kiieran/machine-vision-sorting-arm---MSc-Dissertation/media/Arm_1.jpg

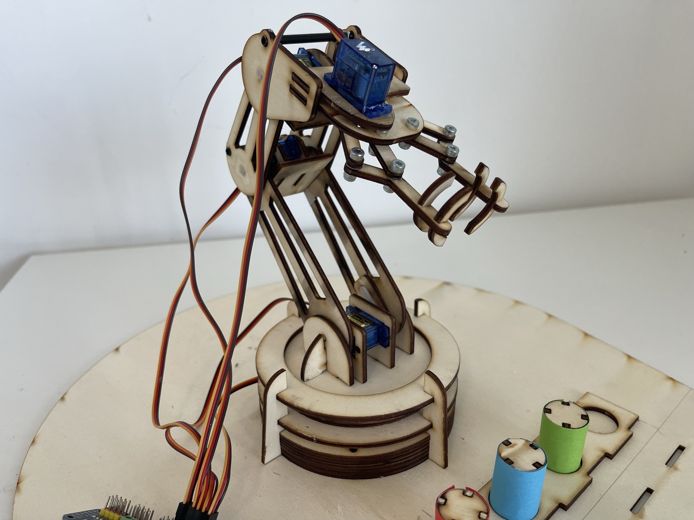
media/Arm_1.jpg
