kiieran/machine-vision-sorting-arm---MSc-Dissertation/media/Arm_2.jpg

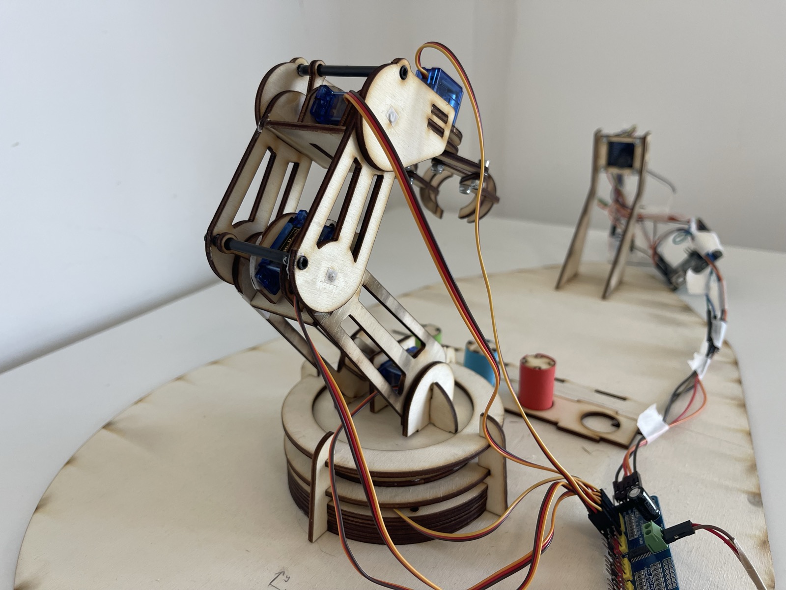
media/Arm_2.jpg
