kiieran/machine-vision-sorting-arm---MSc-Dissertation/media/arm_short.gif

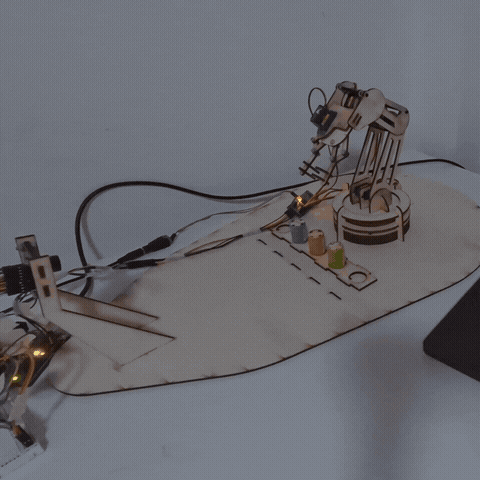
media/arm_short.gif
