kiieran/machine-vision-sorting-arm---MSc-Dissertation/media/Base_bearings_3.jpg

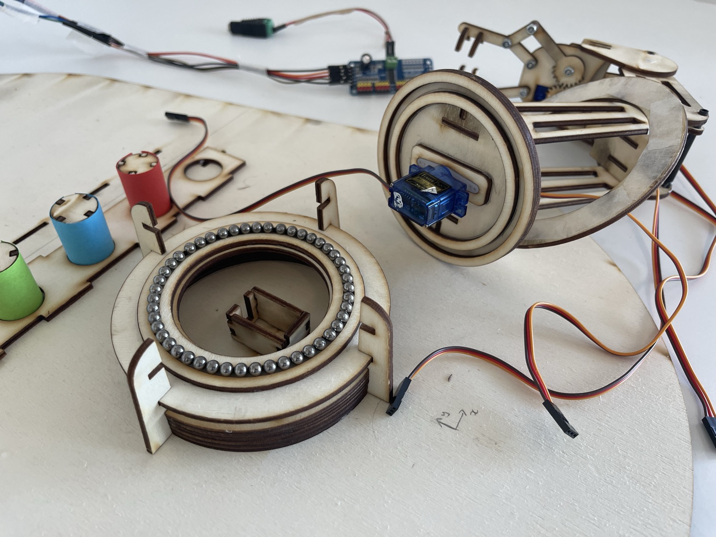
media/Base_bearings_3.jpg
