kiieran/machine-vision-sorting-arm---MSc-Dissertation/media/Base_bearings_4.jpg

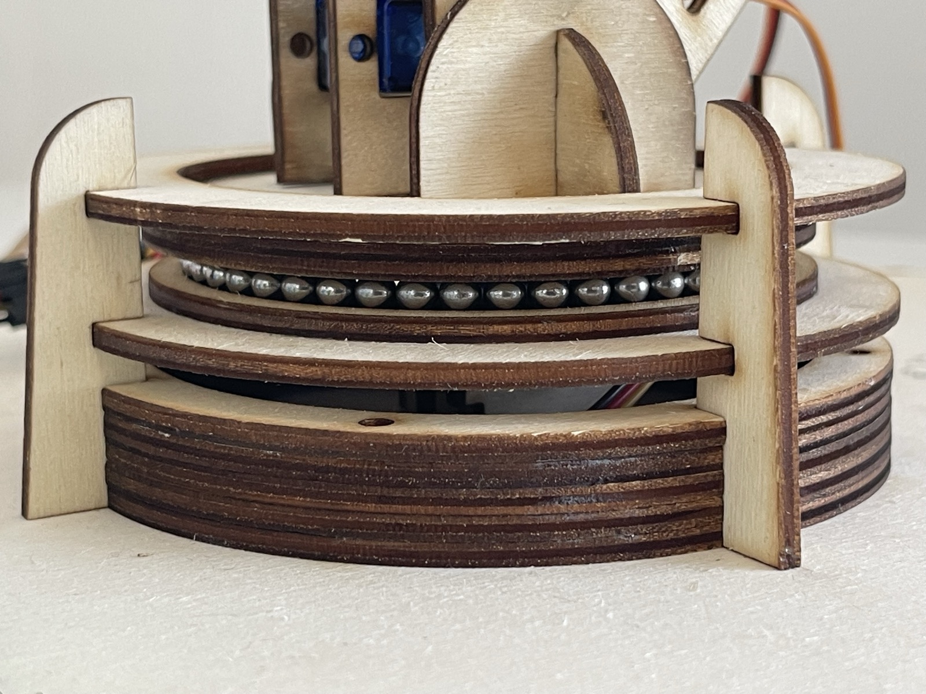
media/Base_bearings_4.jpg
