kiieran/machine-vision-sorting-arm---MSc-Dissertation/media/CAD_arm.jpg

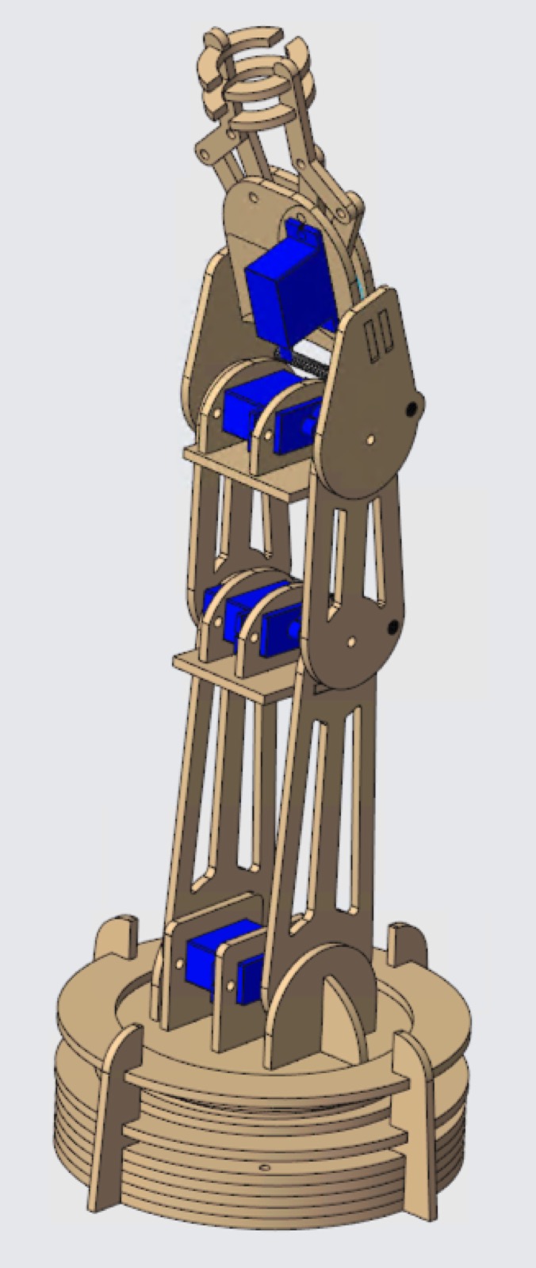
media/CAD_arm.jpg
