kiieran/machine-vision-sorting-arm---MSc-Dissertation/media/Camera_1.jpg

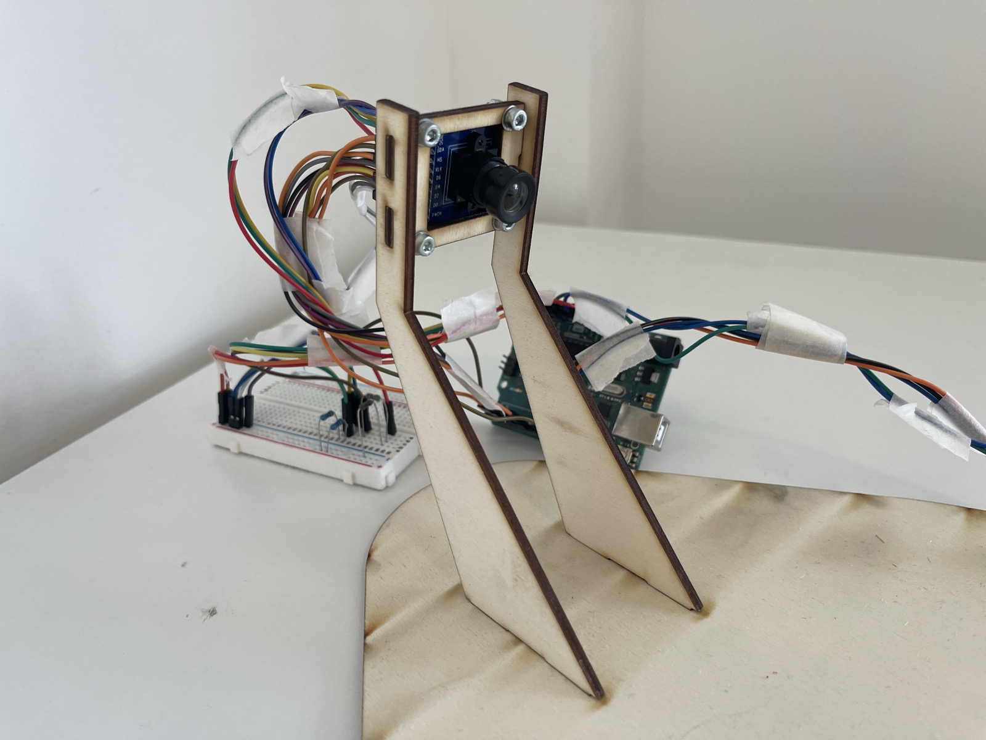
media/Camera_1.jpg
