kiieran/machine-vision-sorting-arm---MSc-Dissertation/media/Camera_3.jpg

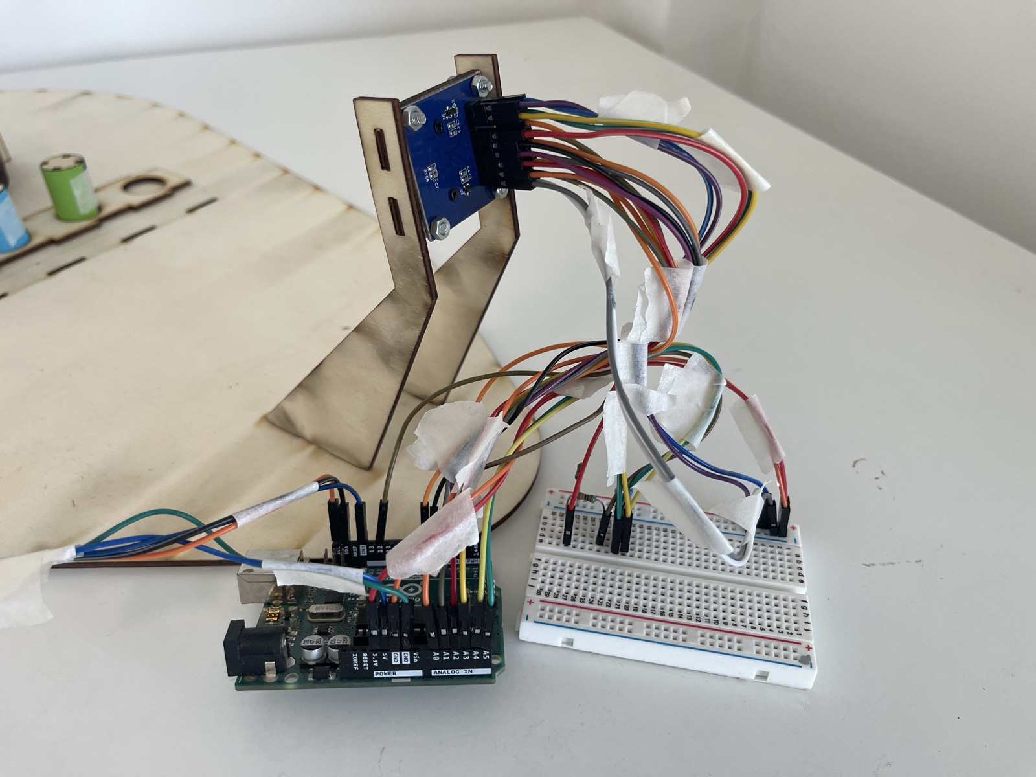
media/Camera_3.jpg
