kiieran/machine-vision-sorting-arm---MSc-Dissertation/media/Vial_colours_confirmed.jpg

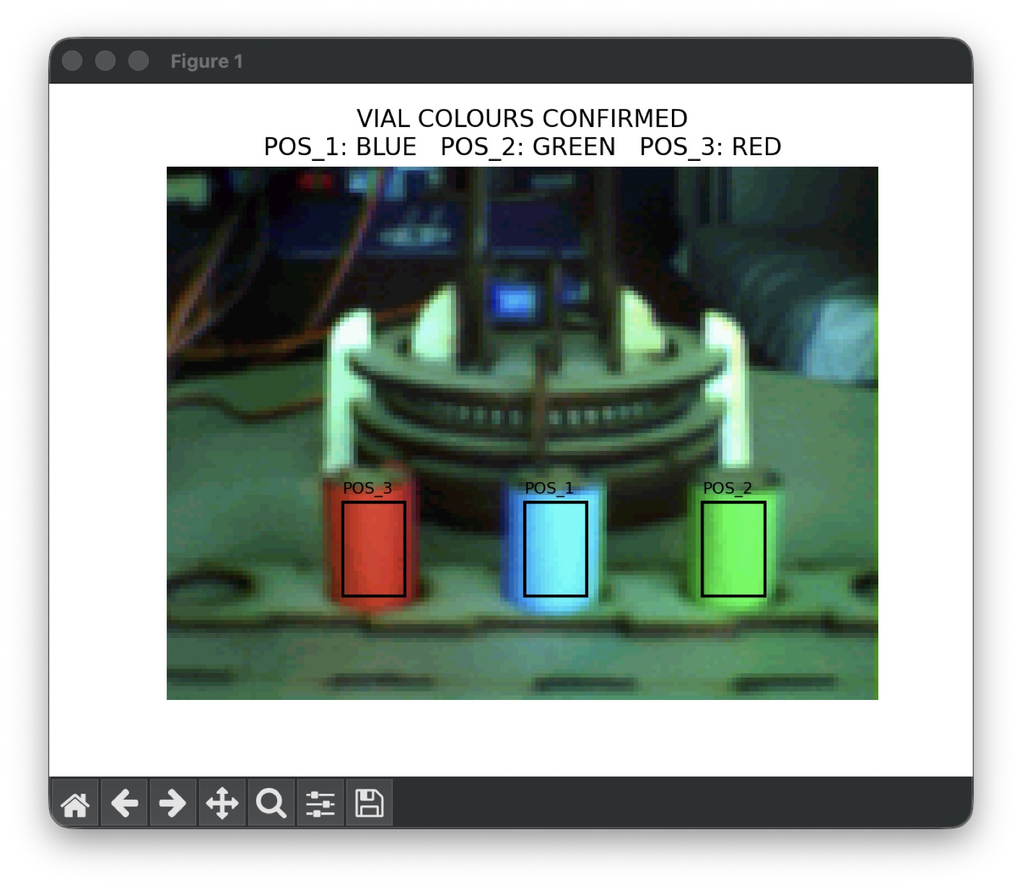
media/Vial_colours_confirmed.jpg
