kiieran/machine-vision-sorting-arm---MSc-Dissertation/arduino_interface/OV7670_UART.cpp

#include "OV7670_UART.h""
#include "Arduino.h"
#include "CameraOV7670.h"

const uint8_t VERSION = 0x10;
const uint8_t COMMAND_NEW_FRAME = 0x01 | VERSION;
const uint8_t COMMAND_DEBUG_DATA = 0x03 | VERSION;

const uint16_t UART_PIXEL_FORMAT_RGB565 = 0x01;
const uint16_t UART_PIXEL_FORMAT_GRAYSCALE = 0x02;

// Pixel byte parity check:
// Pixel Byte H: odd number of bits under H_BYTE_PARITY_CHECK and H_BYTE_PARITY_INVERT
// Pixel Byte L: even number of bits under L_BYTE_PARITY_CHECK and L_BYTE_PARITY_INVERT
//                                          H:RRRRRGGG
const uint8_t H_BYTE_PARITY_CHECK =  0b00100000;
const uint8_t H_BYTE_PARITY_INVERT = 0b00001000;
//                                          L:GGGBBBBB
const uint8_t L_BYTE_PARITY_CHECK =  0b00001000;
const uint8_t L_BYTE_PARITY_INVERT = 0b00100000;
// Since the parity for L byte can be zero we must ensure that the total byet value is above zero.
// Increasing the lowest bit of blue color is OK for that.
const uint8_t L_BYTE_PREVENT_ZERO  = 0b00000001;

const uint16_t COLOR_GREEN = 0x07E0;
const uint16_t COLOR_RED = 0xF800;

void processGrayscaleFrameBuffered();
void processGrayscaleFrameDirect();
void processRgbFrameBuffered();
void processRgbFrameDirect();
typedef void (*ProcessFrameData)(void) ;


#if UART_MODE==1
const uint16_t lineLength = 160;
const uint16_t lineCount = 120;
const uint32_t baud  = 115200;
const ProcessFrameData processFrameData = processRgbFrameBuffered;
const uint16_t lineBufferLength = lineLength * 2;
const bool isSendWhileBuffering = true;
const uint8_t uartPixelFormat = UART_PIXEL_FORMAT_RGB565;
CameraOV7670 camera(CameraOV7670::RESOLUTION_QQVGA_160x120, CameraOV7670::PIXEL_RGB565, 34);
#endif

#if UART_MODE==2
const uint16_t lineLength = 160;
const uint16_t lineCount = 120;
const uint32_t baud  = 115200;
const ProcessFrameData processFrameData = processGrayscaleFrameBuffered;
const uint16_t lineBufferLength = lineLength;
const bool isSendWhileBuffering = true;
const uint8_t uartPixelFormat = UART_PIXEL_FORMAT_GRAYSCALE;
CameraOV7670 camera(CameraOV7670::RESOLUTION_QQVGA_160x120, CameraOV7670::PIXEL_YUV422, 17);
#endif

#if UART_MODE==3
const uint16_t lineLength = 160;
const uint16_t lineCount = 120;
const uint32_t baud  = 500000;
const ProcessFrameData processFrameData = processRgbFrameBuffered;
const uint16_t lineBufferLength = lineLength * 2;
const bool isSendWhileBuffering = true;
const uint8_t uartPixelFormat = UART_PIXEL_FORMAT_RGB565;
CameraOV7670 camera(CameraOV7670::RESOLUTION_QQVGA_160x120, CameraOV7670::PIXEL_RGB565, 8);
#endif

#if UART_MODE==4
const uint16_t lineLength = 160;
const uint16_t lineCount = 120;
const uint32_t baud  = 500000;
const ProcessFrameData processFrameData = processGrayscaleFrameBuffered;
const uint16_t lineBufferLength = lineLength;
const bool isSendWhileBuffering = true;
const uint8_t uartPixelFormat = UART_PIXEL_FORMAT_GRAYSCALE;
CameraOV7670 camera(CameraOV7670::RESOLUTION_QQVGA_160x120, CameraOV7670::PIXEL_YUV422, 4);
#endif

#if UART_MODE==5
const uint16_t lineLength = 320;
const uint16_t lineCount = 240;
const uint32_t baud  = 500000;
const ProcessFrameData processFrameData = processRgbFrameBuffered;
const uint16_t lineBufferLength = lineLength * 2;
const bool isSendWhileBuffering = true;
const uint8_t uartPixelFormat = UART_PIXEL_FORMAT_RGB565;
CameraOV7670 camera(CameraOV7670::RESOLUTION_QVGA_320x240, CameraOV7670::PIXEL_RGB565, 32);
#endif

#if UART_MODE==6
const uint16_t lineLength = 320;
const uint16_t lineCount = 240;
const uint32_t baud  = 500000;
const ProcessFrameData processFrameData = processGrayscaleFrameBuffered;
const uint16_t lineBufferLength = lineLength;
const bool isSendWhileBuffering = true;
const uint8_t uartPixelFormat = UART_PIXEL_FORMAT_GRAYSCALE;
CameraOV7670 camera(CameraOV7670::RESOLUTION_QVGA_320x240, CameraOV7670::PIXEL_YUV422, 16);
#endif

#if UART_MODE==7
const uint16_t lineLength = 160;
const uint16_t lineCount = 120;
const uint32_t baud  = 1000000;
const ProcessFrameData processFrameData = processRgbFrameBuffered;
const uint16_t lineBufferLength = lineLength * 2;
const bool isSendWhileBuffering = false;
const uint8_t uartPixelFormat = UART_PIXEL_FORMAT_RGB565;
CameraOV7670 camera(CameraOV7670::RESOLUTION_QQVGA_160x120, CameraOV7670::PIXEL_RGB565, 5);
#endif

#if UART_MODE==8
const uint16_t lineLength = 160;
const uint16_t lineCount = 120;
const uint32_t baud  = 1000000;
const ProcessFrameData processFrameData = processGrayscaleFrameBuffered;
const uint16_t lineBufferLength = lineLength;
const bool isSendWhileBuffering = false;
const uint8_t uartPixelFormat = UART_PIXEL_FORMAT_GRAYSCALE;
CameraOV7670 camera(CameraOV7670::RESOLUTION_QQVGA_160x120, CameraOV7670::PIXEL_YUV422, 2);
#endif

#if UART_MODE==9
const uint16_t lineLength = 320;
const uint16_t lineCount = 240;
const uint32_t baud  = 1000000;
const ProcessFrameData processFrameData = processRgbFrameBuffered;
const uint16_t lineBufferLength = lineLength * 2;
const bool isSendWhileBuffering = true;
const uint8_t uartPixelFormat = UART_PIXEL_FORMAT_RGB565;
CameraOV7670 camera(CameraOV7670::RESOLUTION_QVGA_320x240, CameraOV7670::PIXEL_RGB565, 16);
#endif

#if UART_MODE==10
const uint16_t lineLength = 320;
const uint16_t lineCount = 240;
const uint32_t baud  = 1000000;
const ProcessFrameData processFrameData = processGrayscaleFrameBuffered;
const uint16_t lineBufferLength = lineLength;
const bool isSendWhileBuffering = true;
const uint8_t uartPixelFormat = UART_PIXEL_FORMAT_GRAYSCALE;
CameraOV7670 camera(CameraOV7670::RESOLUTION_QVGA_320x240, CameraOV7670::PIXEL_YUV422, 8);
#endif

#if UART_MODE==11
const uint16_t lineLength = 640;
const uint16_t lineCount = 480;
const uint32_t baud  = 1000000;
const ProcessFrameData processFrameData = processGrayscaleFrameDirect;
const uint16_t lineBufferLength = 1;
const bool isSendWhileBuffering = true;
const uint8_t uartPixelFormat = UART_PIXEL_FORMAT_GRAYSCALE;
CameraOV7670 camera(CameraOV7670::RESOLUTION_VGA_640x480, CameraOV7670::PIXEL_YUV422, 39);
#endif

#if UART_MODE==12
const uint16_t lineLength = 160;
const uint16_t lineCount = 120;
const uint32_t baud  = 2000000;
const ProcessFrameData processFrameData = processRgbFrameBuffered;
const uint16_t lineBufferLength = lineLength * 2;
const bool isSendWhileBuffering = false;
const uint8_t uartPixelFormat = UART_PIXEL_FORMAT_RGB565;
CameraOV7670 camera(CameraOV7670::RESOLUTION_QQVGA_160x120, CameraOV7670::PIXEL_RGB565, 2);
#endif

#if UART_MODE==13
const uint16_t lineLength = 160;
const uint16_t lineCount = 120;
const uint32_t baud  = 2000000;
const ProcessFrameData processFrameData = processGrayscaleFrameBuffered;
const uint16_t lineBufferLength = lineLength;
const bool isSendWhileBuffering = false;
const uint8_t uartPixelFormat = UART_PIXEL_FORMAT_GRAYSCALE;
CameraOV7670 camera(CameraOV7670::RESOLUTION_QQVGA_160x120, CameraOV7670::PIXEL_YUV422, 2);
#endif

#if UART_MODE==14
const uint16_t lineLength = 320;
const uint16_t lineCount = 240;
const uint32_t baud  = 2000000; // may be unreliable
const ProcessFrameData processFrameData = processRgbFrameBuffered;
const uint16_t lineBufferLength = lineLength * 2;
const bool isSendWhileBuffering = true;
const uint8_t uartPixelFormat = UART_PIXEL_FORMAT_RGB565;
CameraOV7670 camera(CameraOV7670::RESOLUTION_QVGA_320x240, CameraOV7670::PIXEL_RGB565, 12);
#endif

#if UART_MODE==15
const uint16_t lineLength = 320;
const uint16_t lineCount = 240;
const uint32_t baud  = 2000000; // may be unreliable
const ProcessFrameData processFrameData = processGrayscaleFrameBuffered;
const uint16_t lineBufferLength = lineLength;
const bool isSendWhileBuffering = false;
const uint8_t uartPixelFormat = UART_PIXEL_FORMAT_GRAYSCALE;
CameraOV7670 camera(CameraOV7670::RESOLUTION_QVGA_320x240, CameraOV7670::PIXEL_YUV422, 6);
#endif

#if UART_MODE==16
const uint16_t lineLength = 640;
const uint16_t lineCount = 480;
const uint32_t baud  = 2000000;
const ProcessFrameData processFrameData = processRgbFrameDirect;
const uint16_t lineBufferLength = 1;
const bool isSendWhileBuffering = true;
const uint8_t uartPixelFormat = UART_PIXEL_FORMAT_RGB565;
CameraOV7670 camera(CameraOV7670::RESOLUTION_VGA_640x480, CameraOV7670::PIXEL_RGB565, 39);
#endif

#if UART_MODE==17
const uint16_t lineLength = 640;
const uint16_t lineCount = 480;
const uint32_t baud  = 2000000;
const ProcessFrameData processFrameData = processGrayscaleFrameDirect;
const uint16_t lineBufferLength = 1;
const bool isSendWhileBuffering = true;
const uint8_t uartPixelFormat = UART_PIXEL_FORMAT_GRAYSCALE;
CameraOV7670 camera(CameraOV7670::RESOLUTION_VGA_640x480, CameraOV7670::PIXEL_YUV422, 19);
#endif


uint8_t lineBuffer [lineBufferLength]; // Two bytes per pixel
uint8_t * lineBufferSendByte;
bool isLineBufferSendHighByte;
bool isLineBufferByteFormatted;

uint16_t frameCounter = 0;
uint16_t processedByteCountDuringCameraRead = 0;


void commandStartNewFrame(uint8_t pixelFormat);
void commandDebugPrint(const String debugText);
uint8_t sendNextCommandByte(uint8_t checksum, uint8_t commandByte);

void sendBlankFrame(uint16_t color);
inline void processNextGrayscalePixelByteInBuffer() __attribute__((always_inline));
inline void processNextRgbPixelByteInBuffer() __attribute__((always_inline));
inline void tryToSendNextRgbPixelByteInBuffer() __attribute__((always_inline));
inline void formatNextRgbPixelByteInBuffer() __attribute__((always_inline));
inline uint8_t formatRgbPixelByteH(uint8_t byte) __attribute__((always_inline));
inline uint8_t formatRgbPixelByteL(uint8_t byte) __attribute__((always_inline));
inline uint8_t formatPixelByteGrayscaleFirst(uint8_t byte) __attribute__((always_inline));
inline uint8_t formatPixelByteGrayscaleSecond(uint8_t byte) __attribute__((always_inline));
inline void waitForPreviousUartByteToBeSent() __attribute__((always_inline));
inline bool isUartReady() __attribute__((always_inline));



void initializeScreenAndCamera() {

  // Enable this for WAVGAT CPUs
  // For UART communiation we want to set WAVGAT Nano to 16Mhz to match Atmel based Arduino
  //CLKPR = 0x80; // enter clock rate change mode
  //CLKPR = 1; // set prescaler to 1. WAVGAT MCU has it 3 by default.

  Serial.begin(baud);
  if (camera.init()) {
    sendBlankFrame(COLOR_GREEN);
    delay(1000);
  } else {
    sendBlankFrame(COLOR_RED);
    delay(3000);
  }
}


void sendBlankFrame(uint16_t color) {
  uint8_t colorH = (color >> 8) & 0xFF;
  uint8_t colorL = color & 0xFF;

  commandStartNewFrame(UART_PIXEL_FORMAT_RGB565);
  for (uint16_t j=0; j<lineCount; j++) {
    for (uint16_t i=0; i<lineLength; i++) {
      waitForPreviousUartByteToBeSent();
      UDR0 = formatRgbPixelByteH(colorH);
      waitForPreviousUartByteToBeSent();
      UDR0 = formatRgbPixelByteL(colorL);
    }
  }
}




// this is called in Arduino loop() function
void processFrame() {
  processedByteCountDuringCameraRead = 0;
  commandStartNewFrame(uartPixelFormat);
  noInterrupts();
  processFrameData();
  interrupts();
  frameCounter++;
  commandDebugPrint("Frame " + String(frameCounter)/* + " " + String(processedByteCountDuringCameraRead)*/);
  //commandDebugPrint("Frame " + String(frameCounter, 16)); // send number in hexadecimal
}


void processGrayscaleFrameBuffered() {
  camera.waitForVsync();
  commandDebugPrint("Vsync");

  camera.ignoreVerticalPadding();

  for (uint16_t y = 0; y < lineCount; y++) {
    lineBufferSendByte = &lineBuffer[0];
    camera.ignoreHorizontalPaddingLeft();

    uint16_t x = 0;
    while ( x < lineBufferLength) {
      camera.waitForPixelClockRisingEdge(); // YUV422 grayscale byte
      camera.readPixelByte(lineBuffer[x]);
      lineBuffer[x] = formatPixelByteGrayscaleFirst(lineBuffer[x]);

      camera.waitForPixelClockRisingEdge(); // YUV422 color byte. Ignore.
      if (isSendWhileBuffering) {
        processNextGrayscalePixelByteInBuffer();
      }
      x++;

      camera.waitForPixelClockRisingEdge(); // YUV422 grayscale byte
      camera.readPixelByte(lineBuffer[x]);
      lineBuffer[x] = formatPixelByteGrayscaleSecond(lineBuffer[x]);

      camera.waitForPixelClockRisingEdge(); // YUV422 color byte. Ignore.
      if (isSendWhileBuffering) {
        processNextGrayscalePixelByteInBuffer();
      }
      x++;
    }
    camera.ignoreHorizontalPaddingRight();

    // Debug info to get some feedback how mutch data was processed during line read.
    processedByteCountDuringCameraRead = lineBufferSendByte - (&lineBuffer[0]);

    // Send rest of the line
    while (lineBufferSendByte < &lineBuffer[lineLength]) {
      processNextGrayscalePixelByteInBuffer();
    }
  };
}

void processNextGrayscalePixelByteInBuffer() {
  if (isUartReady()) {
    UDR0 = *lineBufferSendByte;
    lineBufferSendByte++;
  }
}


void processGrayscaleFrameDirect() {
  camera.waitForVsync();
  commandDebugPrint("Vsync");

  camera.ignoreVerticalPadding();

  for (uint16_t y = 0; y < lineCount; y++) {
    camera.ignoreHorizontalPaddingLeft();

    uint16_t x = 0;
    while ( x < lineLength) {
      camera.waitForPixelClockRisingEdge(); // YUV422 grayscale byte
      camera.readPixelByte(lineBuffer[0]);
      lineBuffer[0] = formatPixelByteGrayscaleFirst(lineBuffer[0]);

      camera.waitForPixelClockRisingEdge(); // YUV422 color byte. Ignore.
      waitForPreviousUartByteToBeSent();
      UDR0 = lineBuffer[0];
      x++;

      camera.waitForPixelClockRisingEdge(); // YUV422 grayscale byte
      camera.readPixelByte(lineBuffer[0]);
      lineBuffer[0] = formatPixelByteGrayscaleSecond(lineBuffer[0]);

      camera.waitForPixelClockRisingEdge(); // YUV422 color byte. Ignore.
      waitForPreviousUartByteToBeSent();
      UDR0 = lineBuffer[0];
      x++;
    }

    camera.ignoreHorizontalPaddingRight();
  }
}

uint8_t formatPixelByteGrayscaleFirst(uint8_t pixelByte) {
  // For the First byte in the parity chek byte pair the last bit is always 0.
  pixelByte &= 0b11111110;
  if (pixelByte == 0) {
    // Make pixel color always slightly above 0 since zero is a command marker.
    pixelByte |= 0b00000010;
  }
  return pixelByte;
}

uint8_t formatPixelByteGrayscaleSecond(uint8_t pixelByte) {
  // For the second byte in the parity chek byte pair the last bit is always 1.
  return pixelByte | 0b00000001;
}



void processRgbFrameBuffered() {
  camera.waitForVsync();
  commandDebugPrint("Vsync");

  camera.ignoreVerticalPadding();

  for (uint16_t y = 0; y < lineCount; y++) {
    lineBufferSendByte = &lineBuffer[0];
    isLineBufferSendHighByte = true; // Line starts with High byte
    isLineBufferByteFormatted = false;

    camera.ignoreHorizontalPaddingLeft();

    for (uint16_t x = 0; x < lineBufferLength;  x++) {
      camera.waitForPixelClockRisingEdge();
      camera.readPixelByte(lineBuffer[x]);
      if (isSendWhileBuffering) {
        processNextRgbPixelByteInBuffer();
      }
    };

    camera.ignoreHorizontalPaddingRight();

    // Debug info to get some feedback how mutch data was processed during line read.
    processedByteCountDuringCameraRead = lineBufferSendByte - (&lineBuffer[0]);

    // send rest of the line
    while (lineBufferSendByte < &lineBuffer[lineLength * 2]) {
      processNextRgbPixelByteInBuffer();
    }
  }
}

void processNextRgbPixelByteInBuffer() {
  // Format pixel bytes and send out in different cycles.
  // There is not enough time to do both on faster frame rates.
  if (isLineBufferByteFormatted) {
    tryToSendNextRgbPixelByteInBuffer();
  } else {
    formatNextRgbPixelByteInBuffer();
  }
}

void tryToSendNextRgbPixelByteInBuffer() {
  if (isUartReady()) {
    UDR0 = *lineBufferSendByte;
    lineBufferSendByte++;
    isLineBufferByteFormatted = false;
  }
}

void formatNextRgbPixelByteInBuffer() {
  if (isLineBufferSendHighByte) {
    *lineBufferSendByte = formatRgbPixelByteH(*lineBufferSendByte);
  } else {
    *lineBufferSendByte = formatRgbPixelByteL(*lineBufferSendByte);
  }
  isLineBufferByteFormatted = true;
  isLineBufferSendHighByte = !isLineBufferSendHighByte;
}




void processRgbFrameDirect() {
  camera.waitForVsync();
  commandDebugPrint("Vsync");

  camera.ignoreVerticalPadding();

  for (uint16_t y = 0; y < lineCount; y++) {
    camera.ignoreHorizontalPaddingLeft();
    
    for (uint16_t x = 0; x < lineLength; x++) {
      
      camera.waitForPixelClockRisingEdge();
      camera.readPixelByte(lineBuffer[0]);
      lineBuffer[0] = formatRgbPixelByteH(lineBuffer[0]);
      waitForPreviousUartByteToBeSent();
      UDR0 = lineBuffer[0];
      
      camera.waitForPixelClockRisingEdge();
      camera.readPixelByte(lineBuffer[0]);
      lineBuffer[0] = formatRgbPixelByteL(lineBuffer[0]);
      waitForPreviousUartByteToBeSent();
      UDR0 = lineBuffer[0];
    }
    
    camera.ignoreHorizontalPaddingRight();
  };
}


// RRRRRGGG
uint8_t formatRgbPixelByteH(uint8_t pixelByteH) {
  // Make sure that
  // A: pixel color always slightly above 0 since zero is end of line marker
  // B: odd number of bits for H byte under H_BYTE_PARITY_CHECK and H_BYTE_PARITY_INVERT to enable error correction
  if (pixelByteH & H_BYTE_PARITY_CHECK) {
    return pixelByteH & (~H_BYTE_PARITY_INVERT);
  } else {
    return pixelByteH | H_BYTE_PARITY_INVERT;
  }
}


// GGGBBBBB
uint8_t formatRgbPixelByteL(uint8_t pixelByteL) {
  // Make sure that
  // A: pixel color always slightly above 0 since zero is end of line marker
  // B: even number of bits for L byte under L_BYTE_PARITY_CHECK and L_BYTE_PARITY_INVERT to enable error correction
  if (pixelByteL & L_BYTE_PARITY_CHECK) {
    return pixelByteL | L_BYTE_PARITY_INVERT | L_BYTE_PREVENT_ZERO;
  } else {
    return (pixelByteL & (~L_BYTE_PARITY_INVERT)) | L_BYTE_PREVENT_ZERO;
  }
}









void commandStartNewFrame(uint8_t pixelFormat) {
  waitForPreviousUartByteToBeSent();
  UDR0 = 0x00; // New command

  waitForPreviousUartByteToBeSent();
  UDR0 = 4; // Command length

  uint8_t checksum = 0;
  checksum = sendNextCommandByte(checksum, COMMAND_NEW_FRAME);
  checksum = sendNextCommandByte(checksum, lineLength & 0xFF); // lower 8 bits of image width
  checksum = sendNextCommandByte(checksum, lineCount & 0xFF); // lower 8 bits of image height
  checksum = sendNextCommandByte(checksum, 
      ((lineLength >> 8) & 0x03) // higher 2 bits of image width
      | ((lineCount >> 6) & 0x0C) // higher 2 bits of image height
      | ((pixelFormat << 4) & 0xF0));

  waitForPreviousUartByteToBeSent();
  UDR0 = checksum;
}


void commandDebugPrint(const String debugText) {
  if (debugText.length() > 0) {
    
    waitForPreviousUartByteToBeSent();
    UDR0 = 0x00; // New commnad

    waitForPreviousUartByteToBeSent();
    UDR0 = debugText.length() + 1; // Command length. +1 for command code.
    
    uint8_t checksum = 0;
    checksum = sendNextCommandByte(checksum, COMMAND_DEBUG_DATA);
    for (uint16_t i=0; i<debugText.length(); i++) {
      checksum = sendNextCommandByte(checksum, debugText[i]);
    }

    waitForPreviousUartByteToBeSent();
    UDR0 = checksum;
  }
}


uint8_t sendNextCommandByte(uint8_t checksum, uint8_t commandByte) {
  waitForPreviousUartByteToBeSent();
  UDR0 = commandByte;
  return checksum ^ commandByte;
}




void waitForPreviousUartByteToBeSent() {
  while(!isUartReady()); //wait for byte to transmit
}


bool isUartReady() {
  return UCSR0A & (1<<UDRE0);
}
