kiieran/machine-vision-sorting-arm---MSc-Dissertation/arduino_interface/OV7670_UART.h

#ifndef OV7670_UART_H
#define OV7670_UART_H

// select resolution and communication speed:
//  1 - 115200bps 160x120 rgb
//  2 - 115200bps 160x120 grayscale
//  3 - 500000bps 160x120 rgb
//  4 - 500000bps 160x120 grayscale
//  5 - 500000bps 320x240 rgb
//  6 - 500000bps 320x240 grayscale
//  7 - 1Mbps 160x120 rgb
//  8 - 1Mbps 160x120 grayscale
//  9 - 1Mbps 320x240 rgb
// 10 - 1Mbps 320x240 grayscale
// 11 - 1Mbps 640x480 grayscale
// 12 - 2Mbps 160x120 rgb
// 13 - 2Mbps 160x120 grayscale
// 14 - 2Mbps 320x240 rgb
// 15 - 2Mbps 320x240 grayscale
// 16 - 2Mbps 640x480 rgb
// 17 - 2Mbps 640x480 grayscale
#define UART_MODE 1

void initializeScreenAndCamera();
void processFrame();

#endif // OV7670_UART_H
